fangfano/Pull-up-Magnetic-Levitation/Infrared Sensor/demo2.jpg

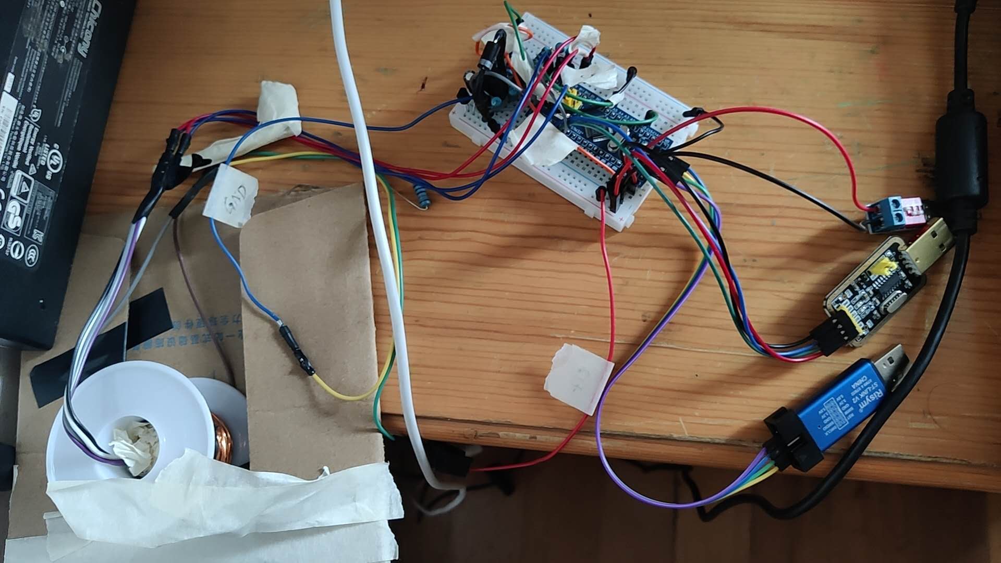
Infrared Sensor/demo2.jpg
