fangfano/Pull-up-Magnetic-Levitation/Infrared Sensor/demo1.jpg

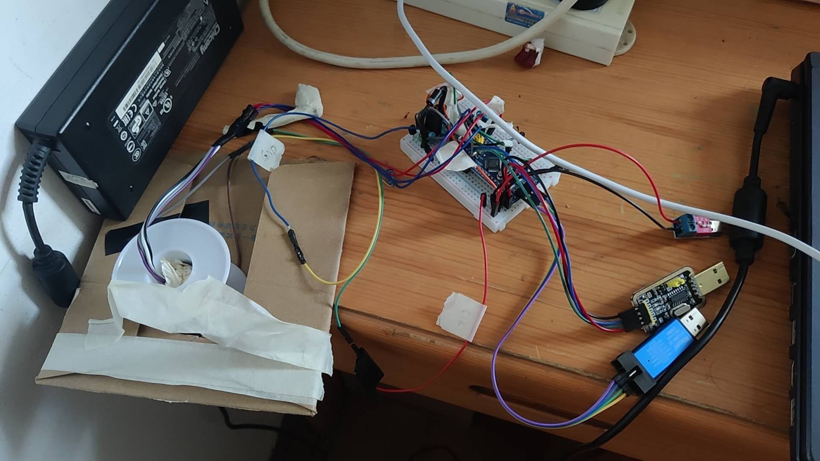
Infrared Sensor/demo1.jpg
