fangfano/Pull-up-Magnetic-Levitation/Infrared Sensor/Principle.png

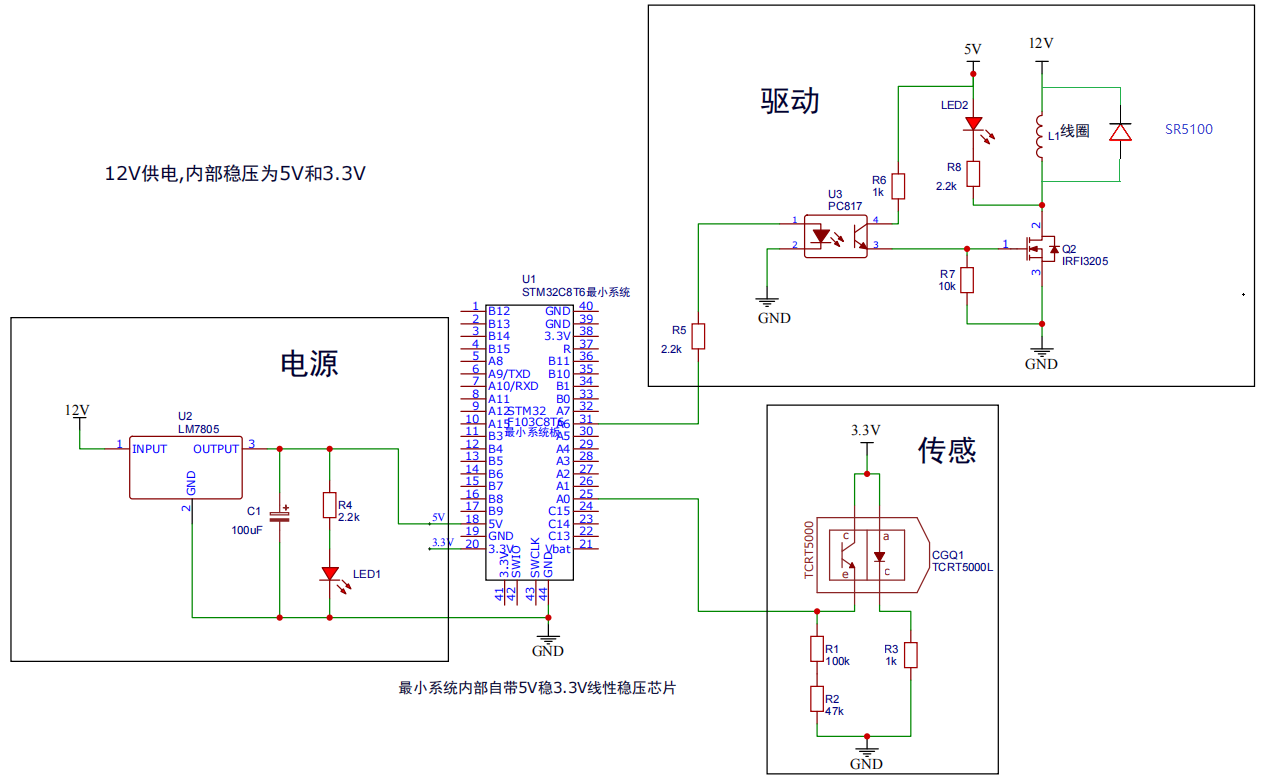
Infrared Sensor/Principle.png
