fangfano/Pull-up-Magnetic-Levitation/yuanlitu.png

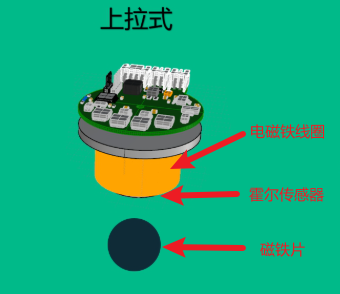
yuanlitu.png
