fangfano/Pull-up-Magnetic-Levitation/Hall Sensor(Verified)/Materials list.xlsx

序号 | 名称 | 型号 | 作用说明 | 价格 | 数量 | 购买链接
1 背景为绿色，表示红外方案和霍尔方案通用的物料 | 可调电源 | 3V-24V 3A带显示屏+母头 | 提供12V输入 | 20 | 1 | https://item.taobao.com/item.htm?from=cart&id=804005711280&skuId=5474092917780&upStreamPrice=2050
2 | 面包板 |  |  | 16 | 1 | https://detail.tmall.com/item.htm?from=cart&id=678239952842&skuId=5158589587801&upStreamPrice=1600
3 | 线圈 | 0.5mm 50m | 电磁线圈，电阻约5欧姆 | 40 | 1 | https://detail.tmall.com/item.htm?from=cart&id=564701853626&skuId=5505463716854&upStreamPrice=4050
4 | 磁铁片 | 20mm*2mm 10片 |  | 9 | 1 | https://detail.tmall.com/item.htm?id=696510908346&last_time=1752542836&upStreamPrice=346&skuId=4965413804657
5 | 铁架台 | 40cm一套 |  | 25 | 1 | https://detail.tmall.com/item.htm?id=811411270321&last_time=1752491199&skuId=5504306960342&upStreamPrice=590
6 | 肖特基二极管SR5100 | SR5100 |  | 2.5 | 1 | https://detail.tmall.com/item.htm?id=784017727344&last_time=1754956173&upStreamPrice=200
7 | arduino UNO | UNO R3改进开发板 送线 |  | 22 | 1 | https://detail.tmall.com/item.htm?from=cart&id=920090708163&skuId=5956401546135&upStreamPrice=1090
8 | L298N电机驱动板模块 |  |  | 5 | 1 | https://item.taobao.com/item.htm?id=818679310199&last_time=1752542488&upStreamPrice=490
9 | 霍尔传感器 | 49E |  | 2.5 | 1 | https://detail.tmall.com/item.htm?id=643097836322&last_time=1752480559&upStreamPrice=225&skuId=5531305469334
10 | 电流检测模块 | 20A | 可要可不要 | 5 | 1 | https://item.taobao.com/item.htm?id=828866349544&last_time=1752757592&upStreamPrice=399
11 | 电阻 | 1K 4.7K |  |  | 1 | https://detail.tmall.com/item.htm?id=531246971343&last_time=1751071819&upStreamPrice=207
