fangfano/Pull-up-Magnetic-Levitation/Infrared Sensor/Materials list.xlsx

序号 | 名称 | 型号 | 作用说明 | 价格 | 数量 | 购买链接
1 背景为绿色，表示红外方案和霍尔方案通用的物料 | 可调电源 | 3V-24V 3A带显示屏+母头 | 提供12V输入 | 20 | 1 | https://item.taobao.com/item.htm?from=cart&id=804005711280&skuId=5474092917780&upStreamPrice=2050
2 | 面包板 |  |  | 16 | 1 | https://detail.tmall.com/item.htm?from=cart&id=678239952842&skuId=5158589587801&upStreamPrice=1600
3 | 线圈 | 0.5mm 50m | 电磁线圈，电阻约5欧姆 | 40.00 | 1.00 | https://detail.tmall.com/item.htm?from=cart&id=564701853626&skuId=5505463716854&upStreamPrice=4050
4 | 磁铁片 | 20mm*2mm 10片 |  | 9 | 1 | https://detail.tmall.com/item.htm?id=696510908346&last_time=1752542836&upStreamPrice=346&skuId=4965413804657
5 | 铁架台 | 40cm一套 |  | 25 | 1 | https://detail.tmall.com/item.htm?id=811411270321&last_time=1752491199&skuId=5504306960342&upStreamPrice=590
6 | 肖特基二极管SR5100 | SR5100 |  | 2.5 | 1 | https://detail.tmall.com/item.htm?id=784017727344&last_time=1754956173&upStreamPrice=200
7 | STM32F103C8T6小系统板 |  |  | 11 | 1 | https://detail.tmall.com/item.htm?from=cart&id=920090708163&skuId=5956401546135&upStreamPrice=1090
8 | ST-LINK V2 | 进口芯片款 |  | 13 | 1 | https://detail.tmall.com/item.htm?from=cart&id=730487163586&skuId=5058401148717&upStreamPrice=1296
9 | 三端稳压管LM7805 | 7805 直插TO-220（2只） |  | 3 | 1 | https://detail.tmall.com/item.htm?id=624225848520&last_time=1752324829&upStreamPrice=204&skuId=4420199748854
10 | TCRT5000红外传感器 |  |  | 3.5 | 1 | https://detail.tmall.com/item.htm?id=679531397706&last_time=1751626282&upStreamPrice=325
11 | PC817光耦 |  |  | 2.5 | 1 | https://item.taobao.com/item.htm?id=572281408940&last_time=1751594147&upStreamPrice=240
12 | IRFI3205 MOS管 |  |  | 1 | 1 | https://item.taobao.com/item.htm?id=693492355924&last_time=1754956013&upStreamPrice=90
13 | USB转TTL模块 | 土豪金USB转TTL |  | 7 | 1 | https://detail.tmall.com/item.htm?id=683362260002&last_time=1751879528&upStreamPrice=400&skuId=5316359732797
14 | 电阻 | 1K 2.2K 10K 47K 100K |  |  | 1 | https://detail.tmall.com/item.htm?id=531246971343&last_time=1751071819&upStreamPrice=207
15 | 电容 | 100uf |  |  | 1 | https://detail.tmall.com/item.htm?id=14588696248
16 | LED |  |  |  | 1 | https://detail.tmall.com/item.htm?id=14525748552
