fangfano/Pull-up-Magnetic-Levitation/Hall Sensor(Verified)/Principle.png

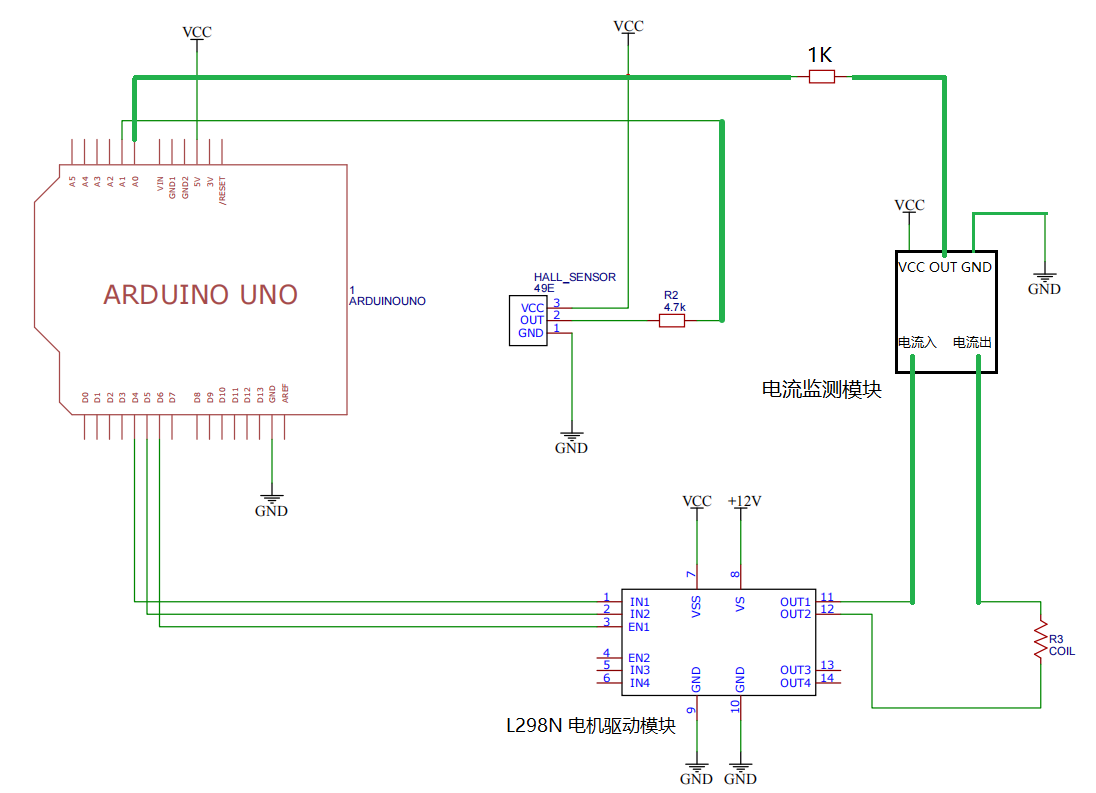
Hall Sensor(Verified)/Principle.png
