fangfano/Pull-up-Magnetic-Levitation/Infrared Sensor/Code/pullUpMagLev/pullUpMagLev.ioc

Mcu.UserName=STM32F103C8Tx
PA0-WKUP.Signal=ADCx_IN0
PA10.Signal=USART1_RX
PA6.Signal=S_TIM3_CH1
PA9.Signal=USART1_TX
PC13-TAMPER-RTC.GPIO_Label=LED
PC13-TAMPER-RTC.Signal=GPIO_Output
PD0-OSC_IN.Signal=RCC_OSC_IN
PD1-OSC_OUT.Signal=RCC_OSC_OUT
