fangfano/Pull-up-Magnetic-Levitation/(notices)

Notices in the files:
Infrared Sensor/Code/pullUpMagLev/Core/Src/main.c:
© Copyright (c) 2021 STMicroelectronics.
All rights reserved.
